adsehgal/KiCad_Libraries/3-D Parts/ESP32-S2-WROVER.STEP

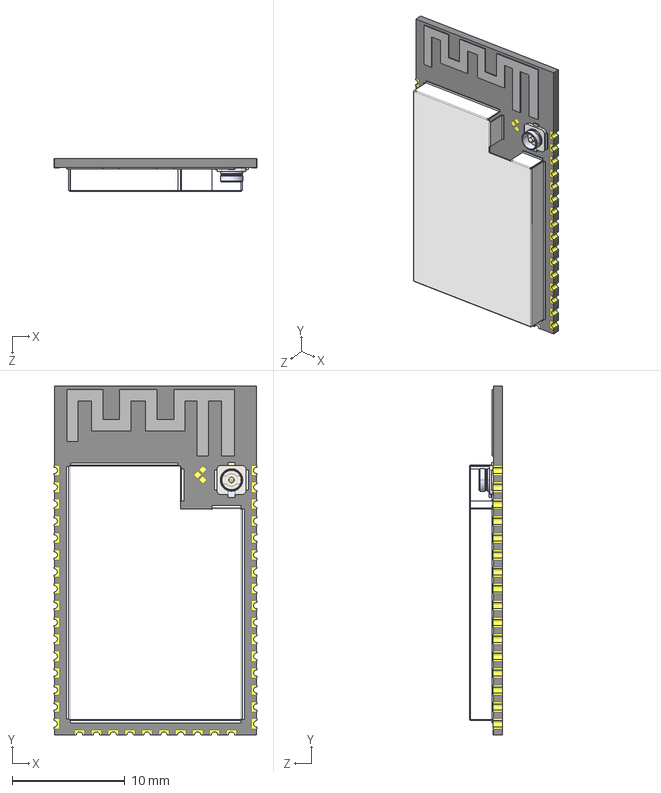
[picture p1: CAD file, 2020-09-27]
3-D Parts/ESP32-S2-WROVER.STEP
18.0 x 31.0 x 2.91 mm
