adsehgal/KiCad_Libraries/3-D Parts/Relay_ALQ305.step

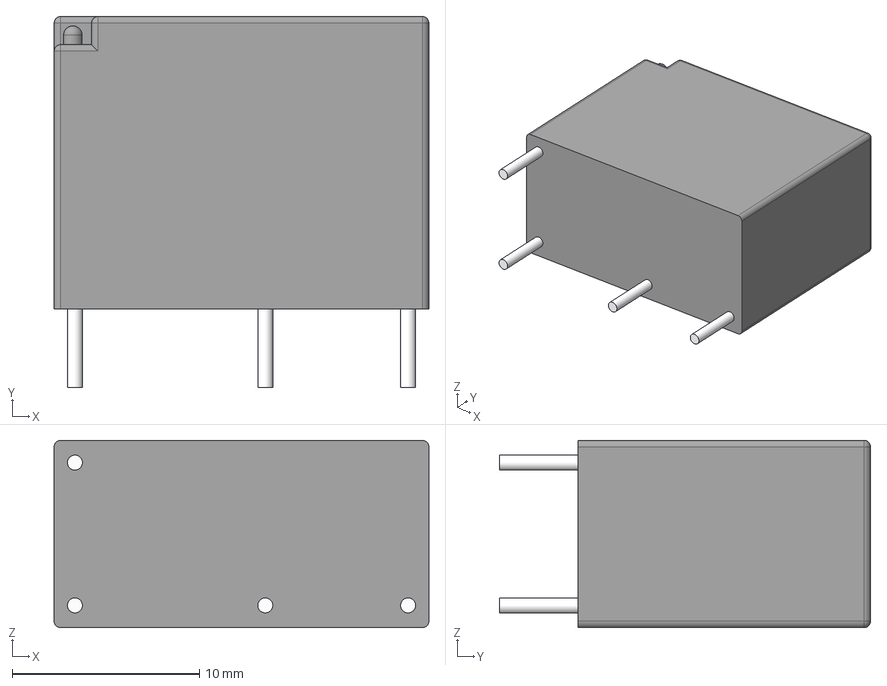
[picture p2: CAD file, 2020-09-07]
3-D Parts/Relay_ALQ305.step
20.0 x 19.8 x 10.0 mm
