adsehgal/KiCad_Libraries/3-D Parts/0.91_ OLED.step

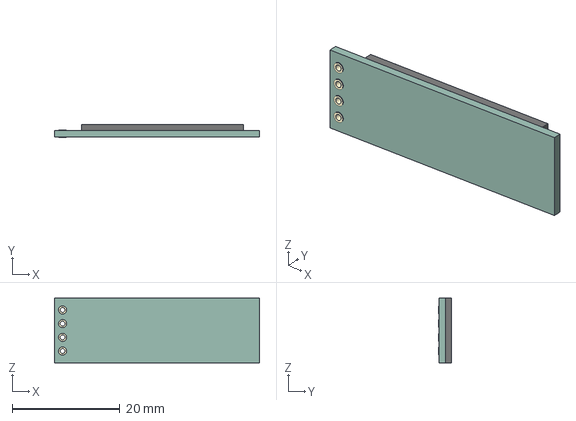
[picture p3: CAD file, 2020-09-07]
3-D Parts/0.91_ OLED.step
38.0 x 2.50 x 12.0 mm
