adsehgal/KiCad_Libraries/3-D Parts/AC_DC_TAS40-12-W.step

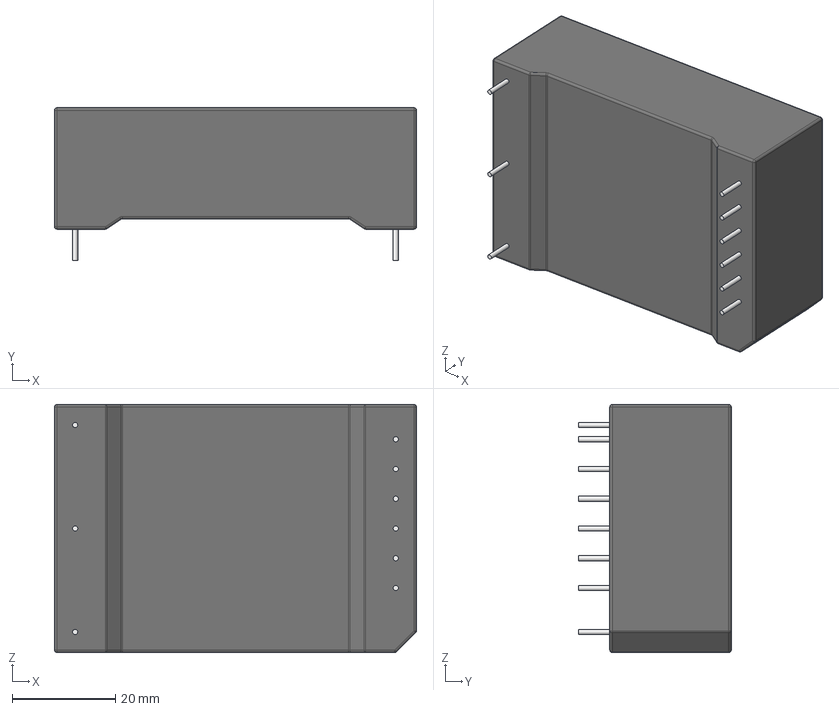
[picture p4: CAD file, 2020-09-05]
3-D Parts/AC_DC_TAS40-12-W.step
70.0 x 29.5 x 48.0 mm
