adsehgal/KiCad_Libraries/3-D Parts/BPT_Switch_20x13.step

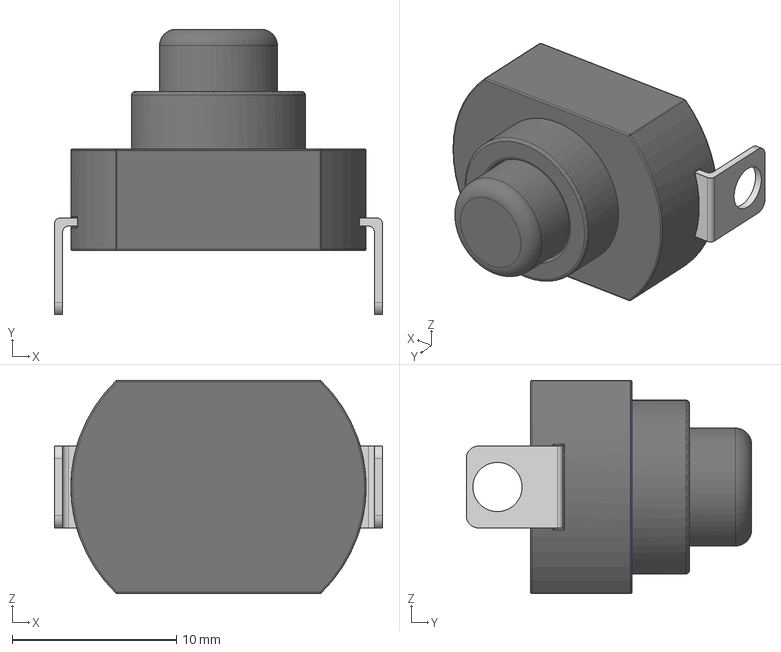
[picture p5: CAD file, 2020-09-05]
3-D Parts/BPT_Switch_20x13.step
20.0 x 17.4 x 13.0 mm
