adsehgal/KiCad_Libraries/3-D Parts/IEC_Connector_ACT3KD-03BT3B018.step

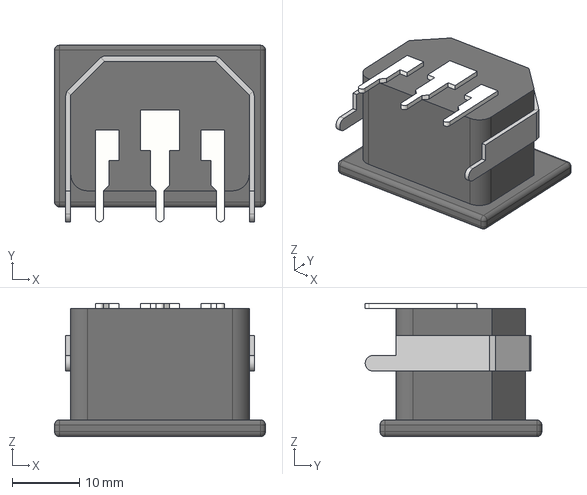
[picture p6: CAD file, 2020-09-05]
3-D Parts/IEC_Connector_ACT3KD-03BT3B018.step
31.3 x 26.2 x 19.8 mm
