adsehgal/KiCad_Libraries/3-D Parts/LittleFuse_0443002.step

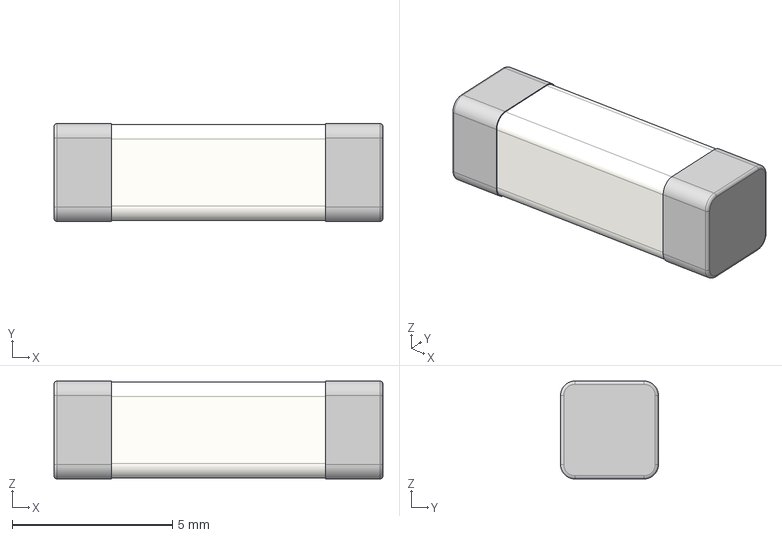
[picture p7: CAD file, 2020-09-05]
3-D Parts/LittleFuse_0443002.step
10.2 x 3.05 x 3.05 mm
