adsehgal/KiCad_Libraries/3-D Parts/HDMI_Jing_C168714.step

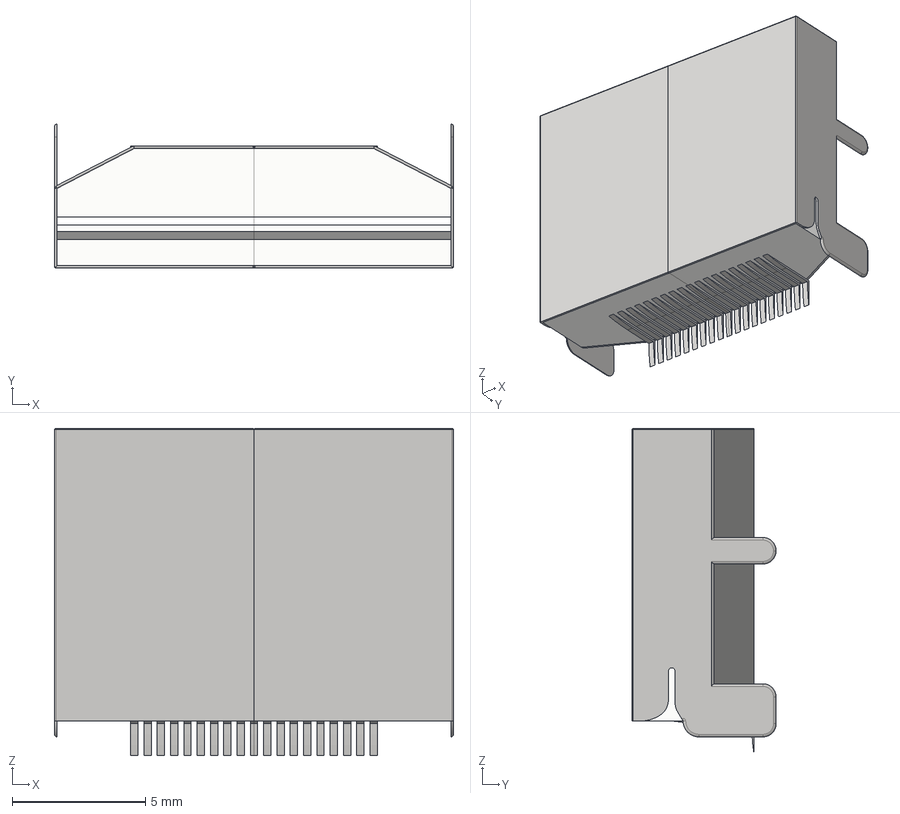
[picture p8: CAD file, 2020-08-28]
3-D Parts/HDMI_Jing_C168714.step
15.0 x 5.42 x 12.3 mm
leg
leg (1) (1) (1)
leg (1) (1) (1) (1) (1)
leg (1) (1) (1) (1) (1) (1) (1) (1)
leg (1) (1) (1) (1) (1) (1) (1) (1) (1)
leg (1)
leg (1) (1)
leg (1) (1) (1) (1)
leg (1) (1) (1) (1) (1) (1)
leg (1) (1) (1) (1) (1) (1) (1)
Bodytop
plastic
leg(Mirror)
leg (1) (1) (1)(Mirror)
leg (1) (1) (1) (1) (1)(Mirror)
leg (1) (1) (1) (1) (1) (1) (1) (1)(Mirror)
leg (1) (1) (1) (1) (1) (1) (1) (1) (1)(Mirror)
leg (1)(Mirror)
leg (1) (1)(Mirror)
leg (1) (1) (1) (1)(Mirror)
leg (1) (1) (1) (1) (1) (1)(Mirror)
leg (1) (1) (1) (1) (1) (1) (1)(Mirror)
Bodytop(Mirror)
plastic(Mirror)
