adsehgal/KiCad_Libraries/3-D Parts/SSD1306_0.96in.step

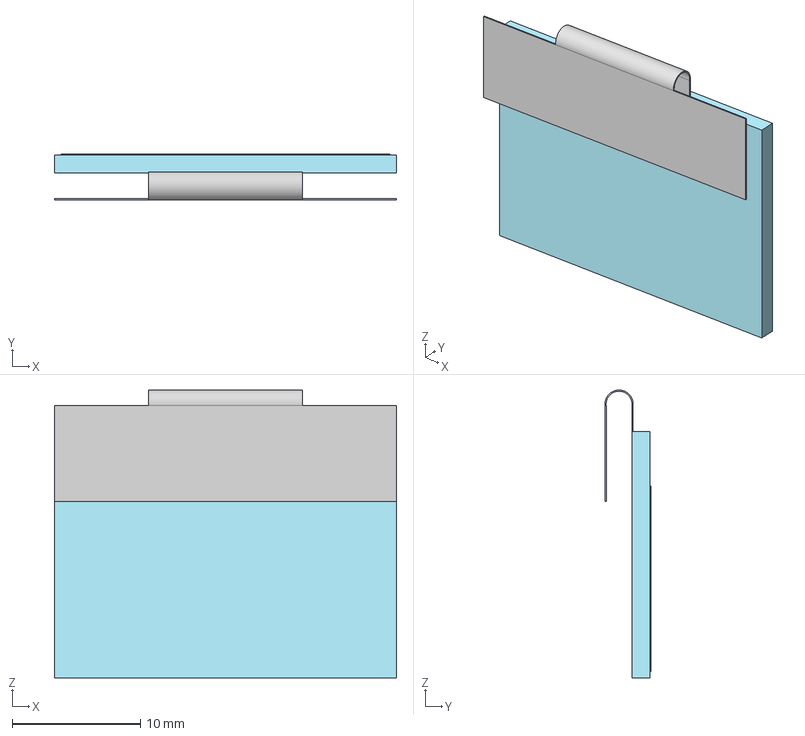
[picture p9: CAD file, 2020-08-28]
3-D Parts/SSD1306_0.96in.step
26.7 x 3.61 x 22.5 mm
