adsehgal/KiCad_Libraries/3-D Parts/USB Type C Port (SMD Type).STEP

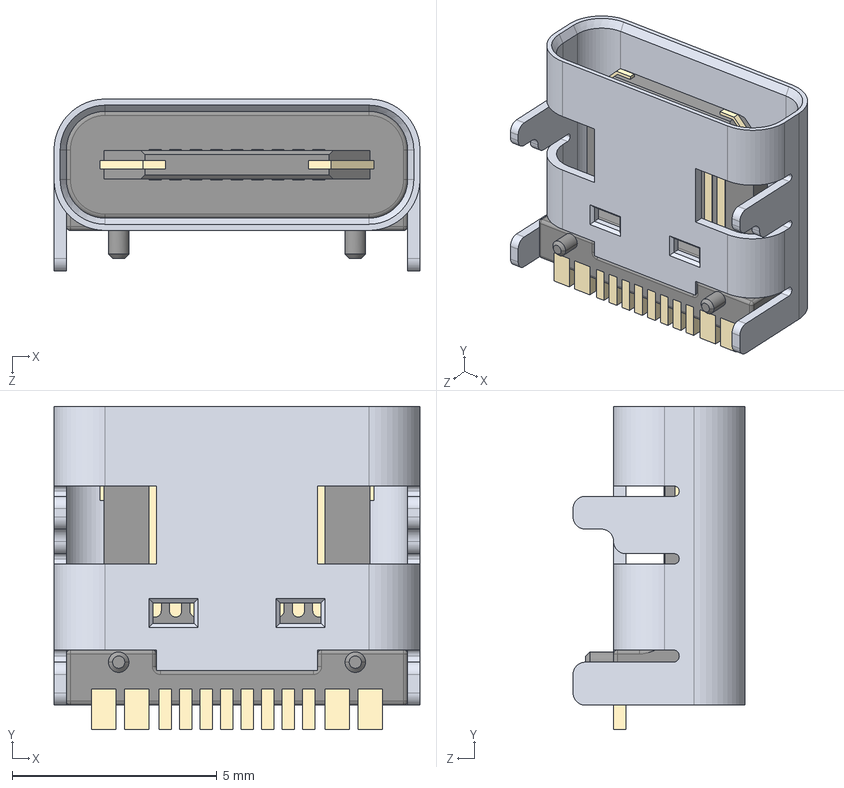
[picture p10: CAD file, 2020-08-28]
3-D Parts/USB Type C Port (SMD Type).STEP
8.94 x 7.90 x 4.20 mm
