adsehgal/KiCad_Libraries/3-D Parts/Alchitry_Conn_Female.step

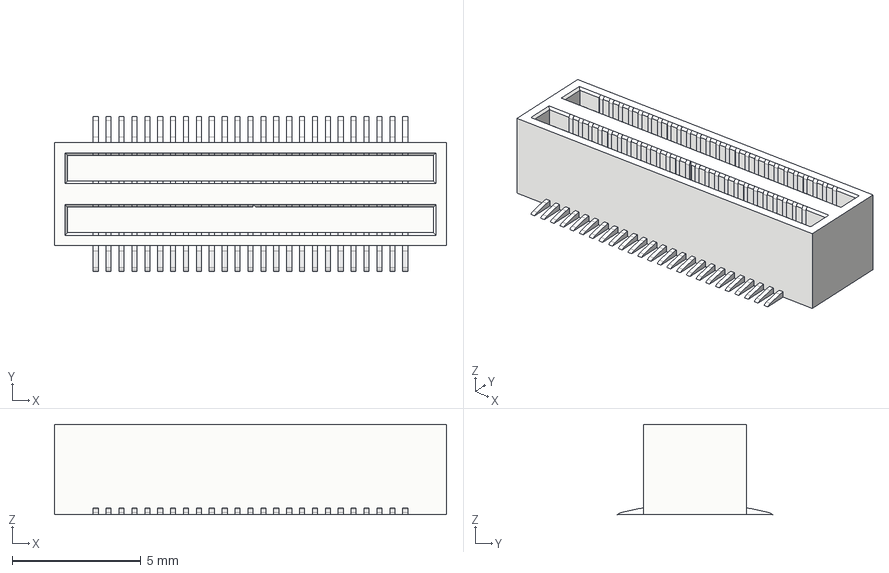
[picture p11: CAD file, 2020-08-21]
3-D Parts/Alchitry_Conn_Female.step
15.2 x 6.02 x 3.50 mm
Female body
