adsehgal/KiCad_Libraries/3-D Parts/Button Korean Hroparts Elec K2-1177SR v25.step

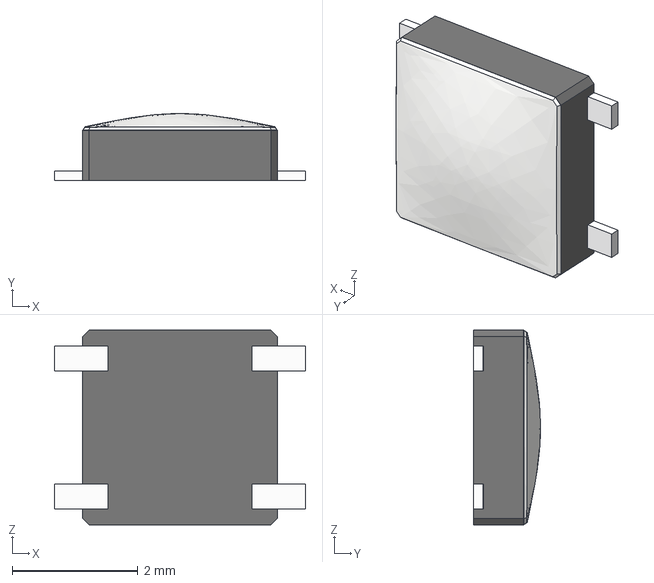
[picture p12: CAD file, 2020-08-21]
3-D Parts/Button Korean Hroparts Elec K2-1177SR v25.step
4.00 x 1.07 x 3.10 mm
