adsehgal/KiCad_Libraries/3-D Parts/Alchitry_Conn_Male.step

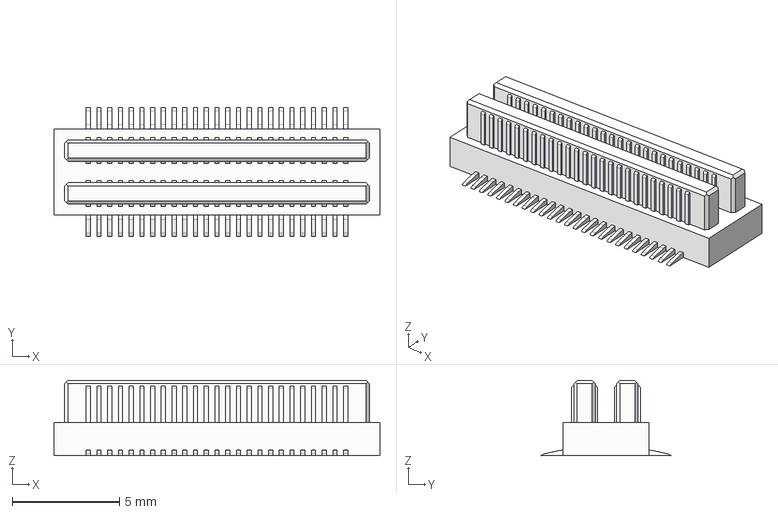
[picture p13: CAD file, 2020-08-21]
3-D Parts/Alchitry_Conn_Male.step
15.2 x 6.02 x 3.50 mm
Female body
