adsehgal/KiCad_Libraries/(commit log)

2020-05-19 pushed some old footprints
2020-06-05 pushed script to create castellation footprints and script to sort and edit pin header for custom definitions
2020-08-21 created more new libs and footprints
    [Alchitry_Conn_Female.step, Alchitry_Conn_Male.step, Button Korean Hroparts Elec K2-1177SR v25.step]
2020-08-28 added connectors lib
    [HDMI_Jing_C168714.step, SSD1306_0.96in.step, USB Type C Port (SMD Type).STEP]
2020-09-05 added jumpers and psu parts
    [AC_DC_TAS40-12-W.step, BPT_Switch_20x13.step, IEC_Connector_ACT3KD-03BT3B018.step, LittleFuse_0443002.step]
2020-09-07 added more parts
    [0.91_ OLED.step, Relay_ALQ305.step]
2020-09-27 added eps32s2wroom libs
    [ESP32-S2-WROVER.STEP]
